fablabuae/mePed-V2.1/PCB/MEPED OUTLINE.png

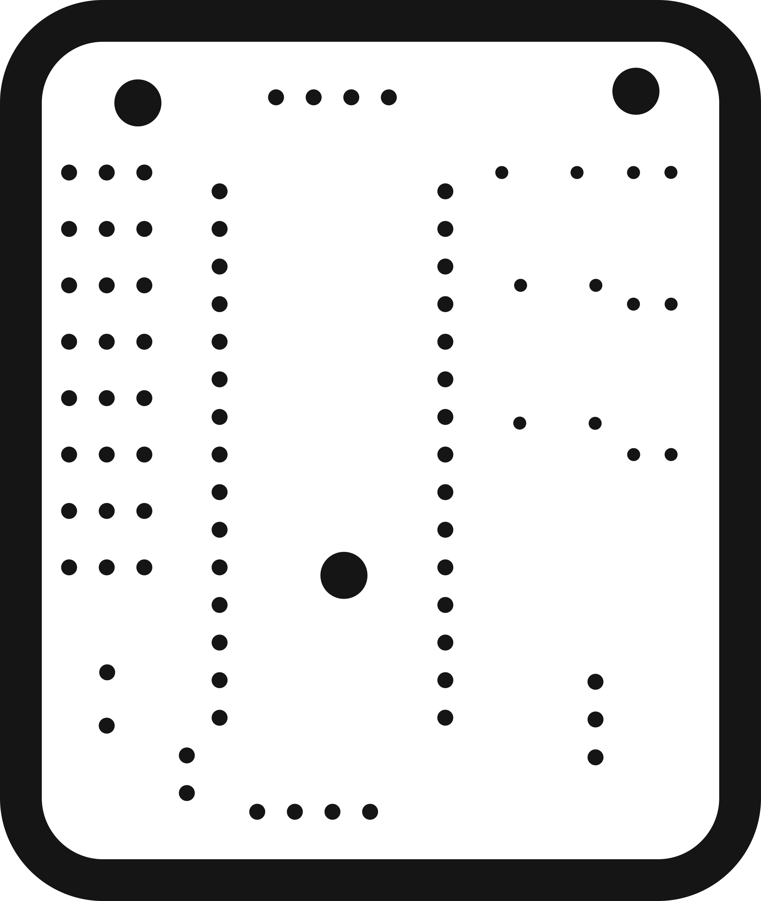
PCB/MEPED OUTLINE.png
