fablabuae/mePed-V2.1/PCB/MEPED TRACES.png

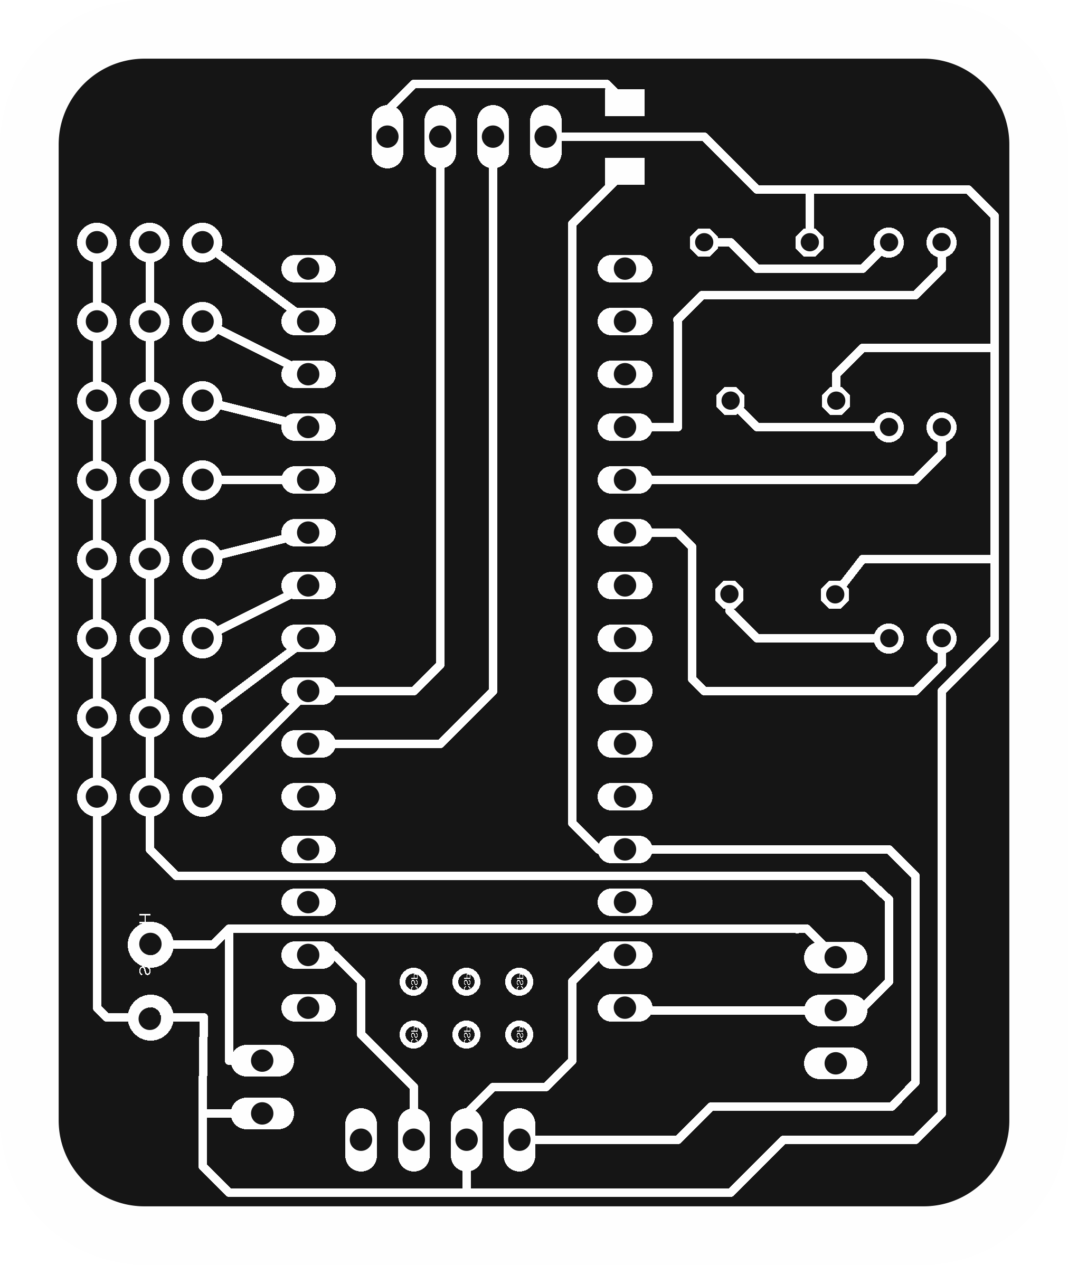
PCB/MEPED TRACES.png
