fablabuae/mePed-V2.1/Laser Cut Frame/lasercut frame.pdf

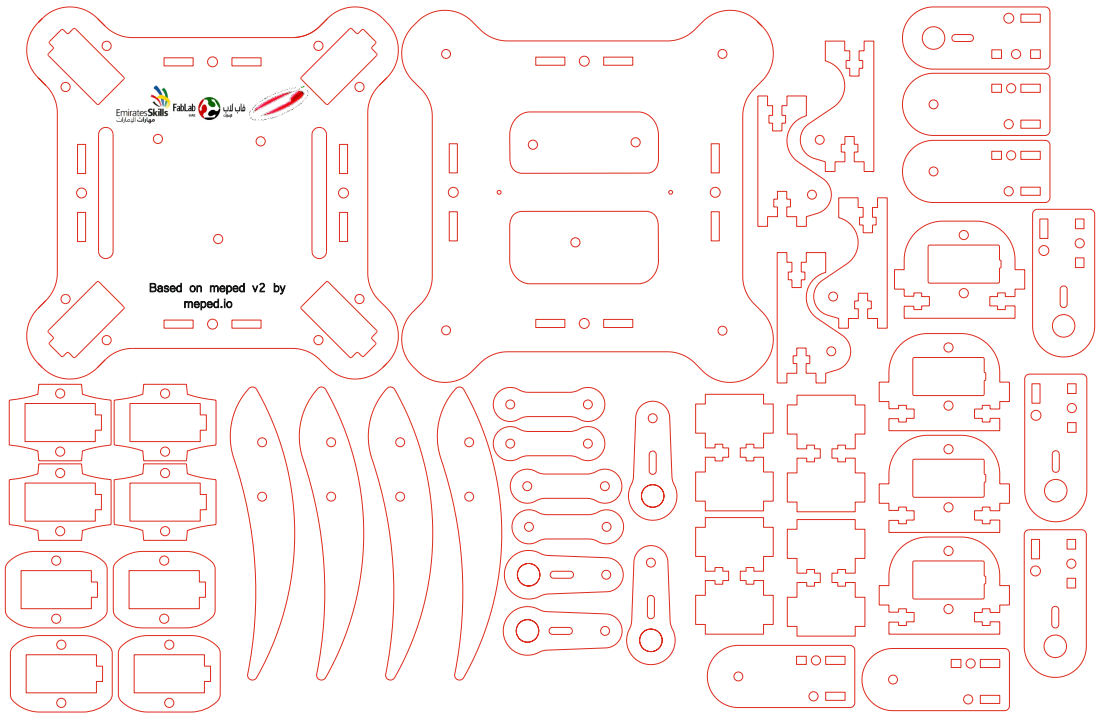
[picture p3: page 1]

Based on meped v2 by
meped.io
