fablabuae/mePed-V2.1/PCB/meped.brd

## EAGLE design PCB/meped.brd (2018-05-03)

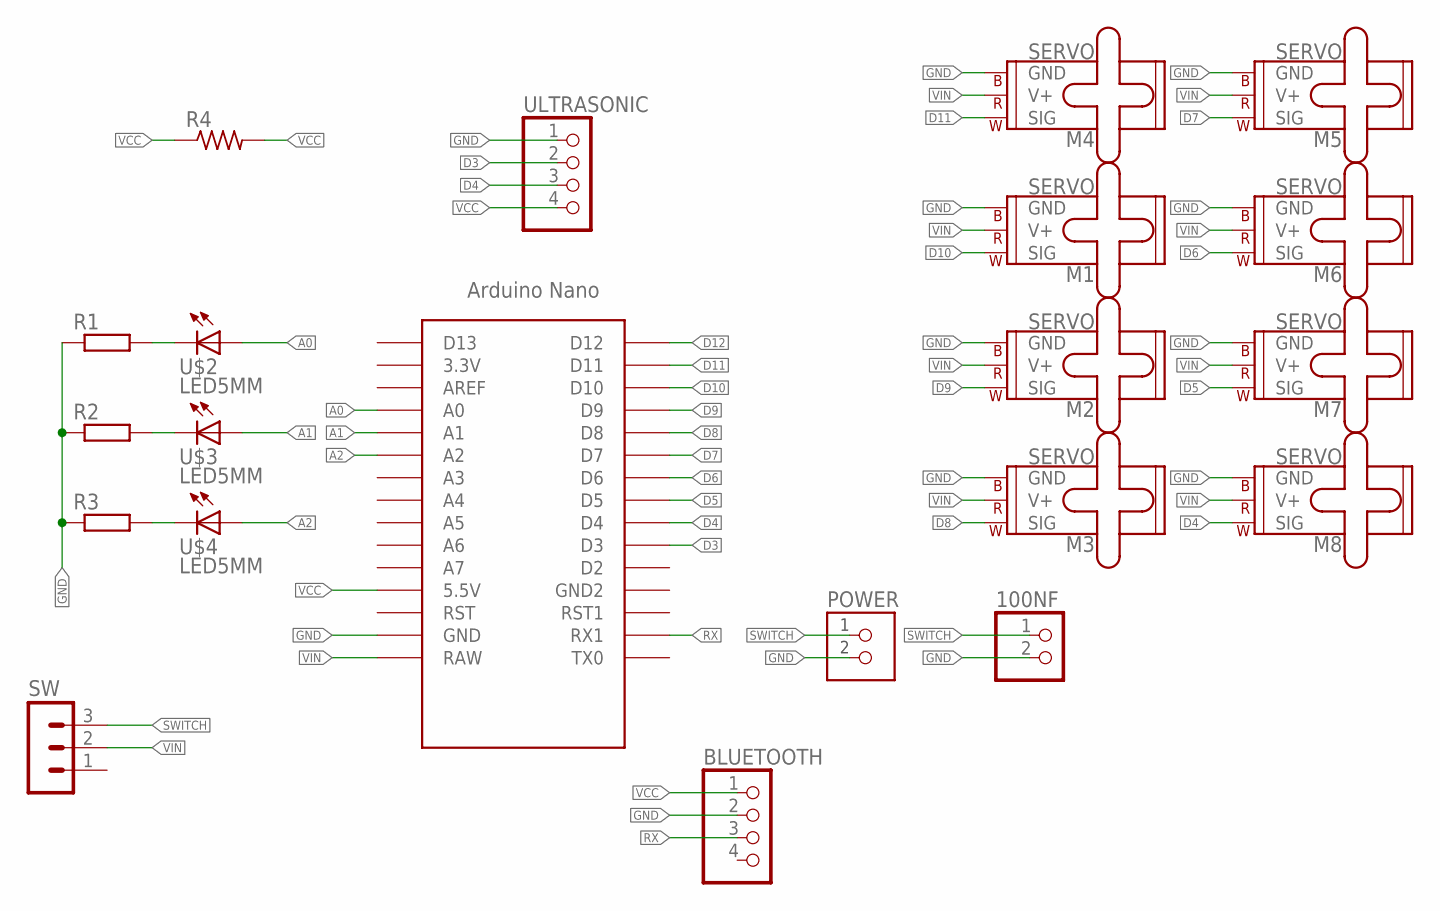
[picture p4: schematic meped.sch]

Parts:
100NF: PINHD-1X2; 1X02
BLUETOOTH: PINHD-1X4; 1X04
M1, M2, M3, M4, M5, M6, M7, M8: SERVO; 1X03
POWER: TERM-1X02-ADAFRUIT; 3.5MMTERM
R1, R2, R3: R-EU_0204/5; 0204/5
R4: RES-US1206FAB; R1206FAB
SW: MA03-1
U$1: NANO
U$2, U$3, U$4: LED5MM; 5MM
ULTRASONIC: PINHD-1X4; 1X04

Connections:
A0: U$1.A0, U$2.IN (A)
A1: U$1.A1, U$3.IN (A)
A2: U$1.A2, U$4.IN (A)
D3: U$1.D3, ULTRASONIC.2
D4: M8.1 (SIG), U$1.D4, ULTRASONIC.3
D5: M7.1 (SIG), U$1.D5
D6: M6.1 (SIG), U$1.D6
D7: M5.1 (SIG), U$1.D7
D8: M3.1 (SIG), U$1.D8
D9: M2.1 (SIG), U$1.D9
D10: M1.1 (SIG), U$1.D10
D11: M4.1 (SIG), U$1.D11
D12: U$1.D12
GND: 100NF.2, BLUETOOTH.2, M1.3 (GND), M2.3 (GND), M3.3 (GND), M4.3 (GND), M5.3 (GND), M6.3 (GND), M7.3 (GND), M8.3 (GND), POWER.2, R1.1, R2.1, R3.1, U$1.GND, ULTRASONIC.1
unnamed: R1.2, U$2.OUT (C)
unnamed: R2.2, U$3.OUT (C)
unnamed: R3.2, U$4.OUT (C)
RX: BLUETOOTH.3, U$1.RX1
SWITCH: 100NF.1, POWER.1, SW.3
VCC: BLUETOOTH.1, R4.1, R4.2, U$1.5V (5.5V), ULTRASONIC.4
VIN: M1.2 (V+), M2.2 (V+), M3.2 (V+), M4.2 (V+), M5.2 (V+), M6.2 (V+), M7.2 (V+), M8.2 (V+), SW.2, U$1.RAW

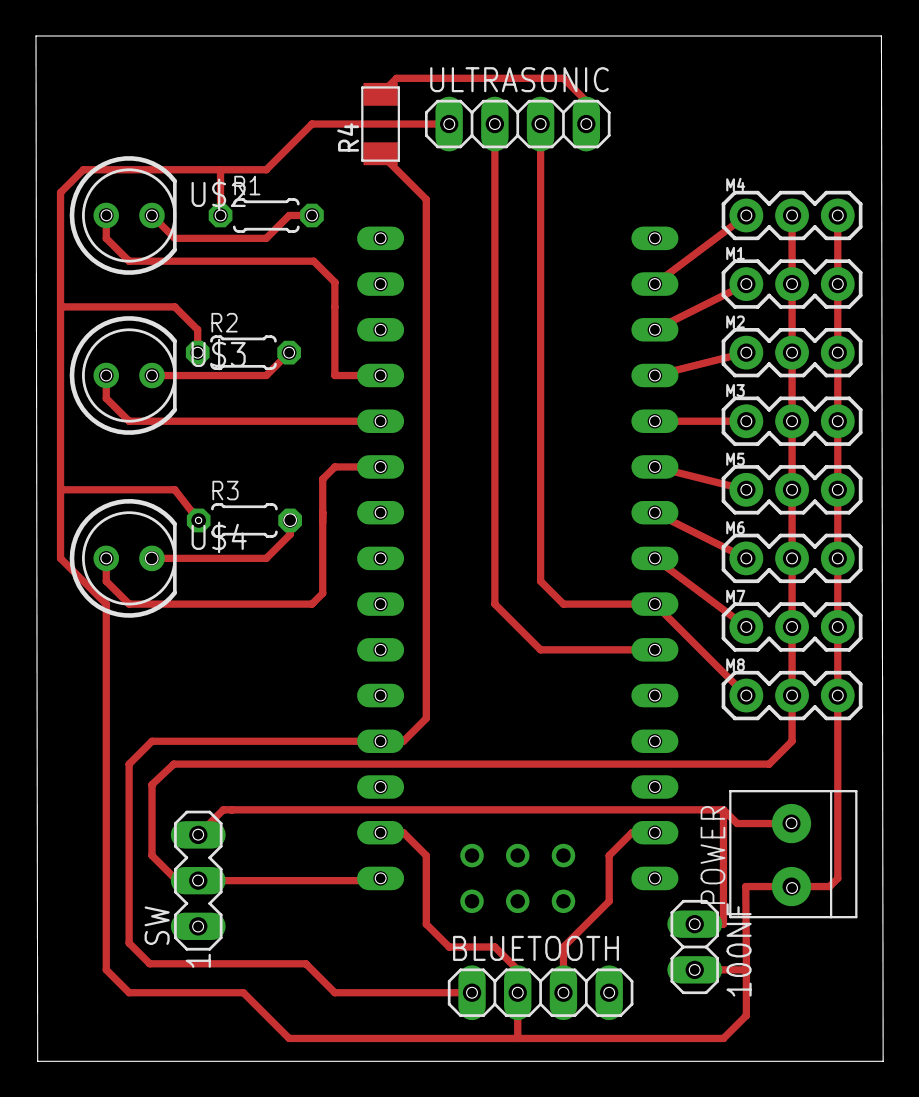
[picture p5: board meped.brd from above]

Board: 2 copper layers, 47.1 x 57.0 mm, 21 parts (0 on the bottom side), 20 nets.
