fablabuae/mePed-V2.1/(commit log)

2018-05-03 added the initial files
    [meped.brd, meped.sch]
2018-05-03 added the assembly isntructions
